jrengdahl/MSCP/QBusH723Z-JLCPCB-0.1/44007569240064-Produce_DanZhi.SMT_Snapshot.Top.5651051A_Y5.SMT02405081732156.png

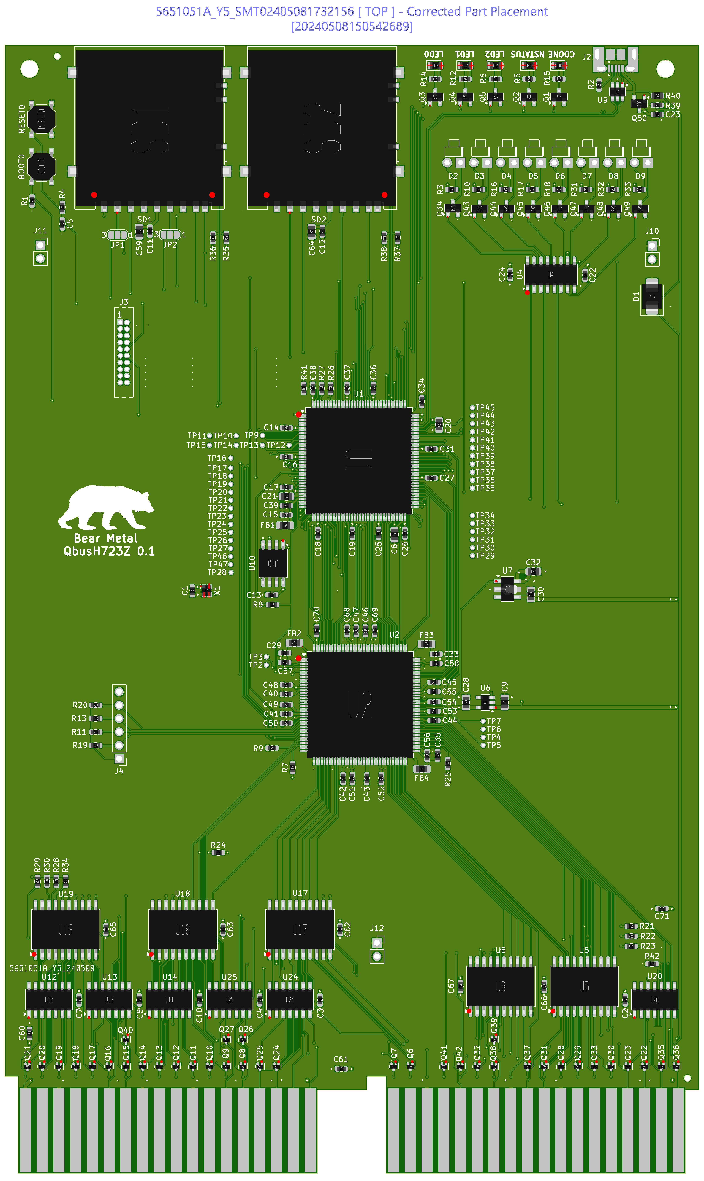
QBusH723Z-JLCPCB-0.1/44007569240064-Produce_DanZhi.SMT_Snapshot.Top.5651051A_Y5.SMT02405081732156.png
