jrengdahl/MSCP/QBusH723Z-JLCPCB-0.1/QBusH723Z.kicad_sch

## KiCad design QBusH723Z-JLCPCB-0.1/QBusH723Z.kicad_sch (2024-05-27)

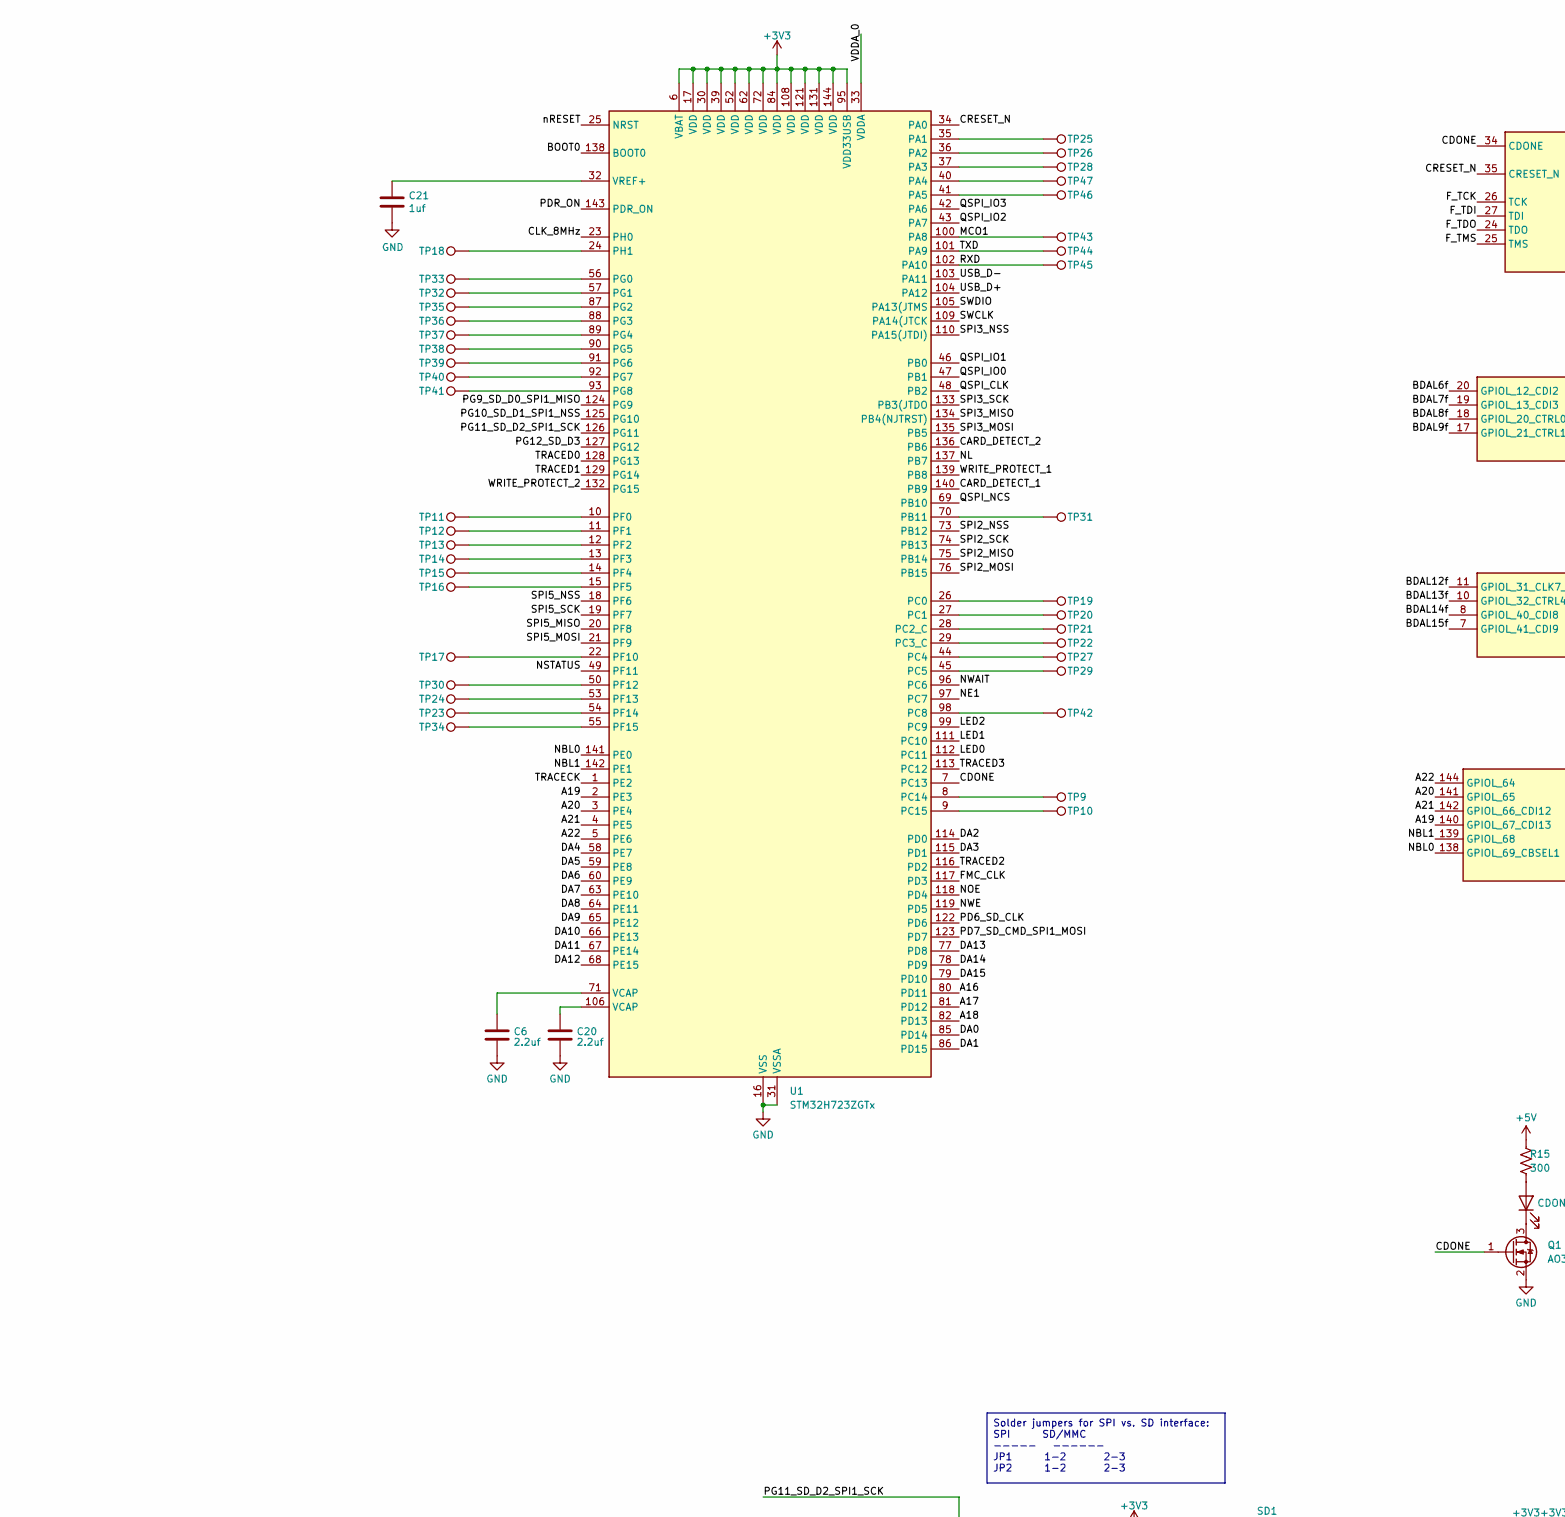
[picture p2: schematic QBusH723Z.kicad_sch, part in row 1, column 1]

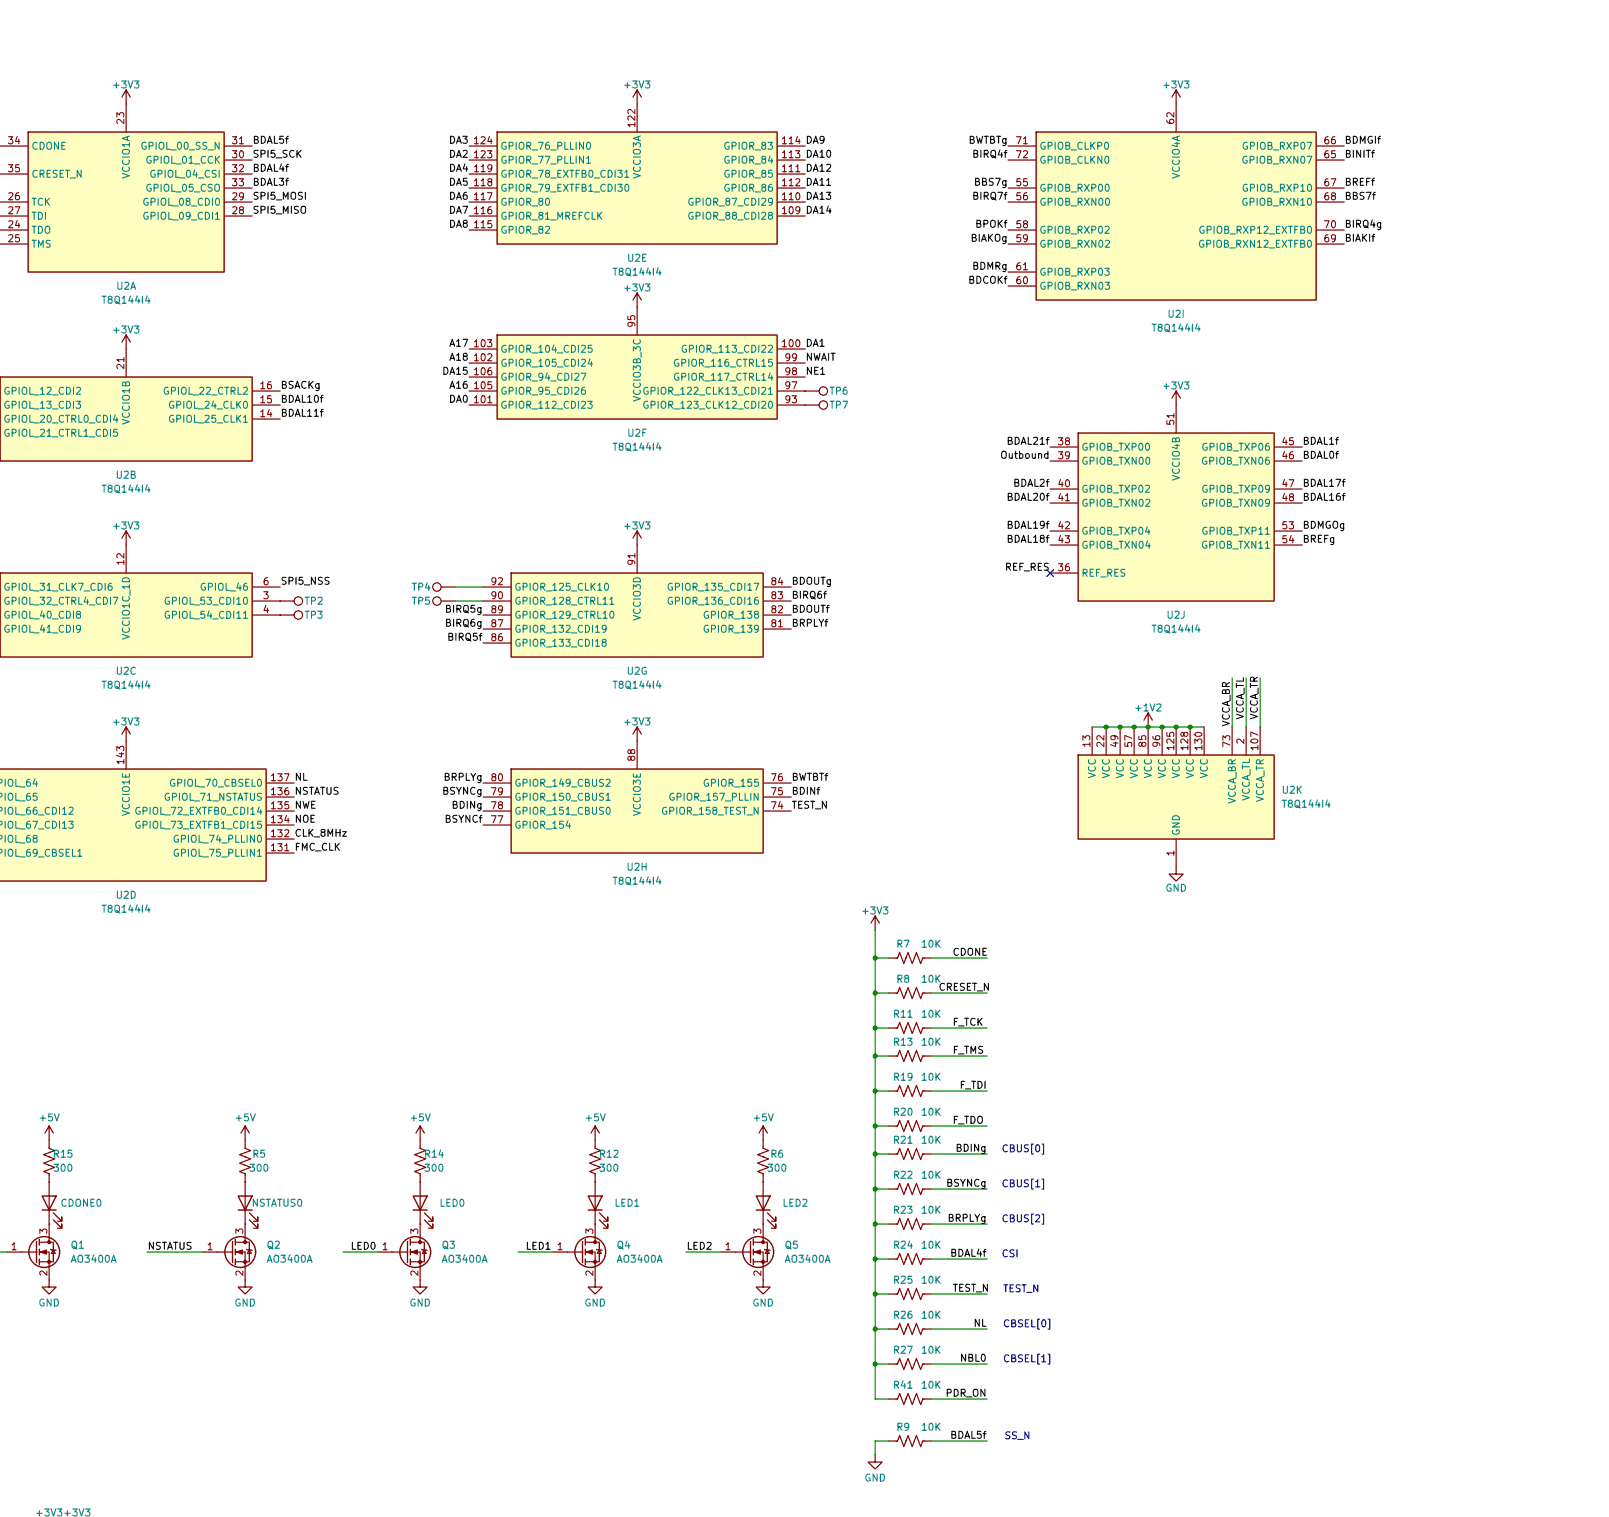
[picture p3: schematic QBusH723Z.kicad_sch, part in row 1, column 2]

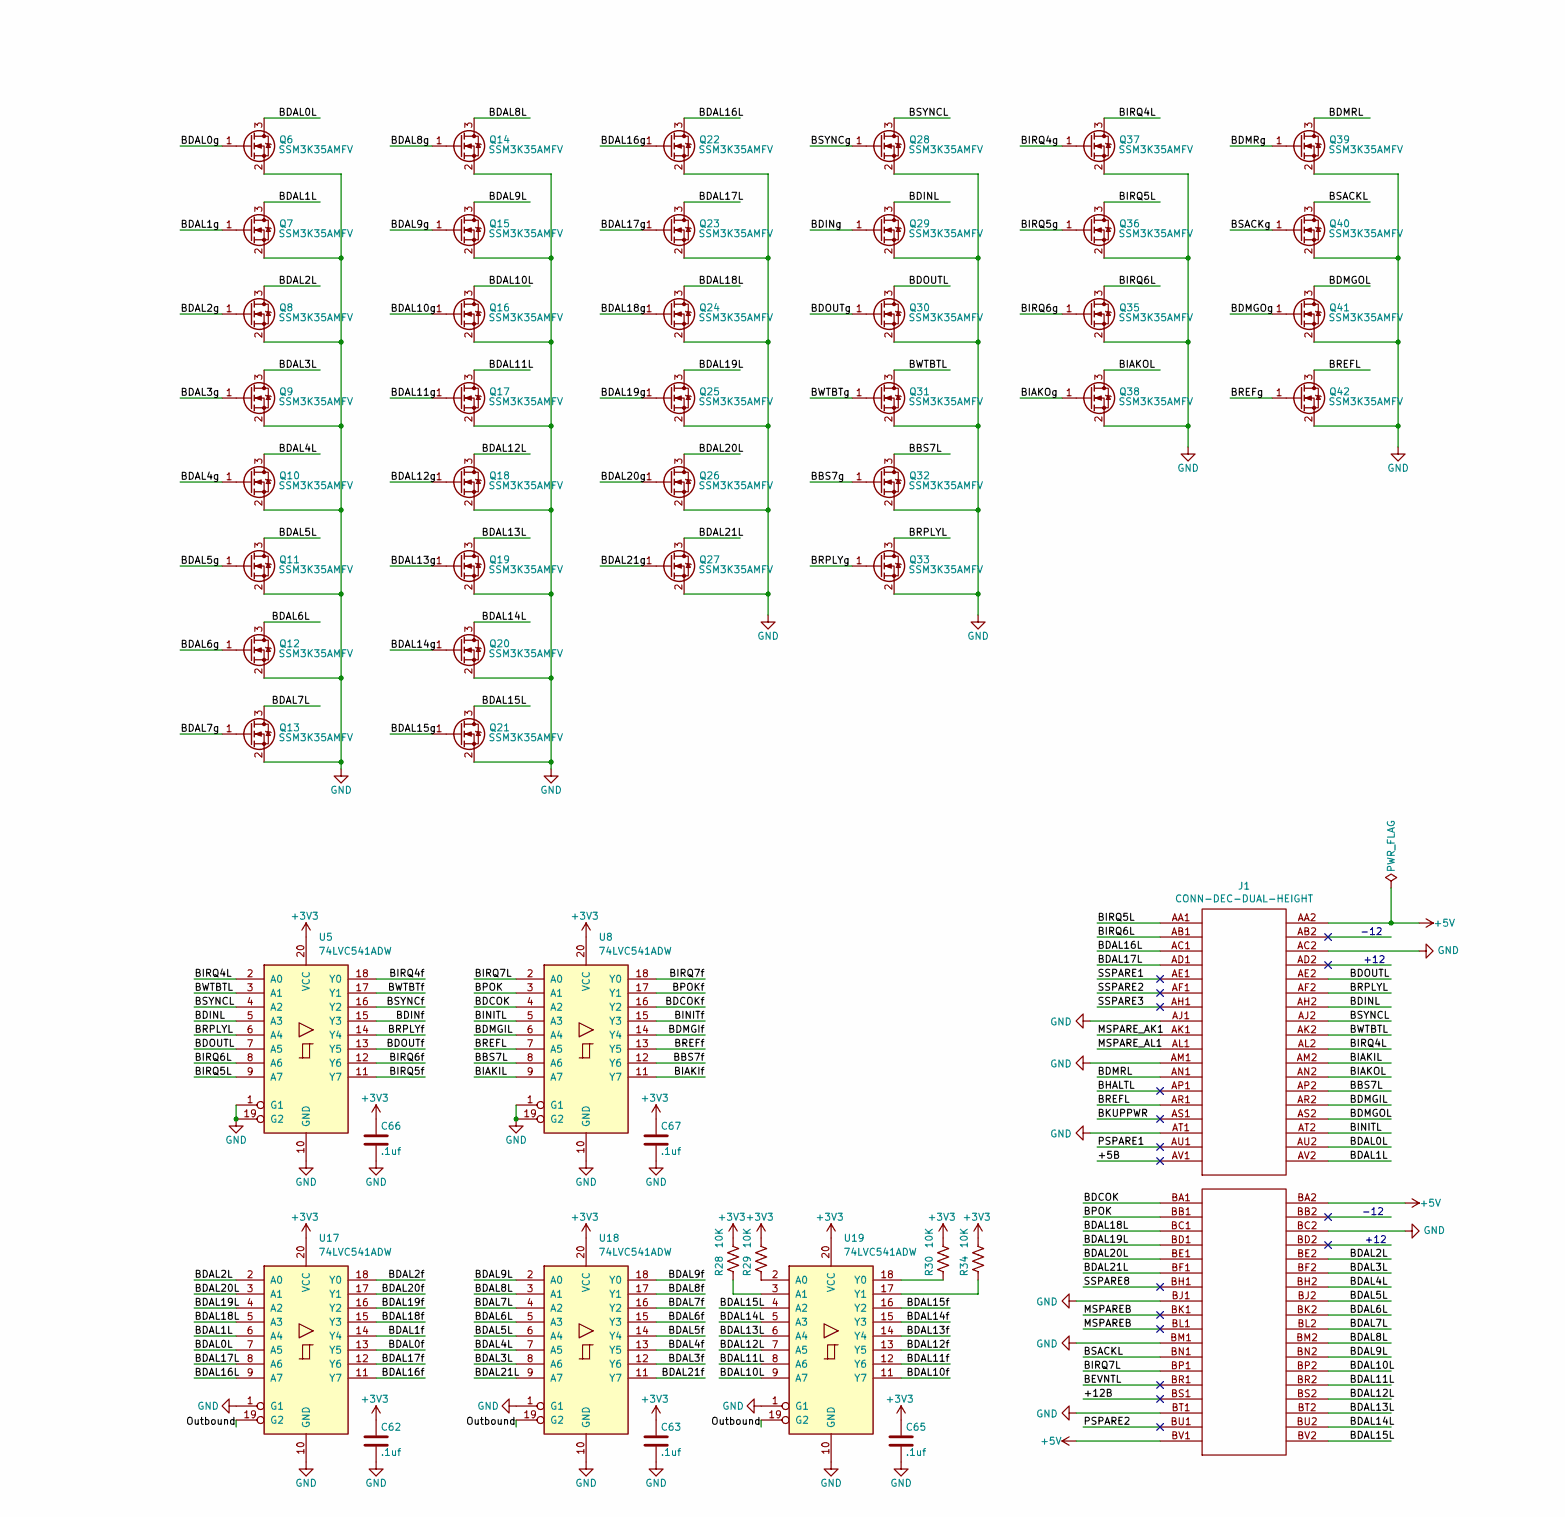
[picture p4: schematic QBusH723Z.kicad_sch, part in row 1, column 3]

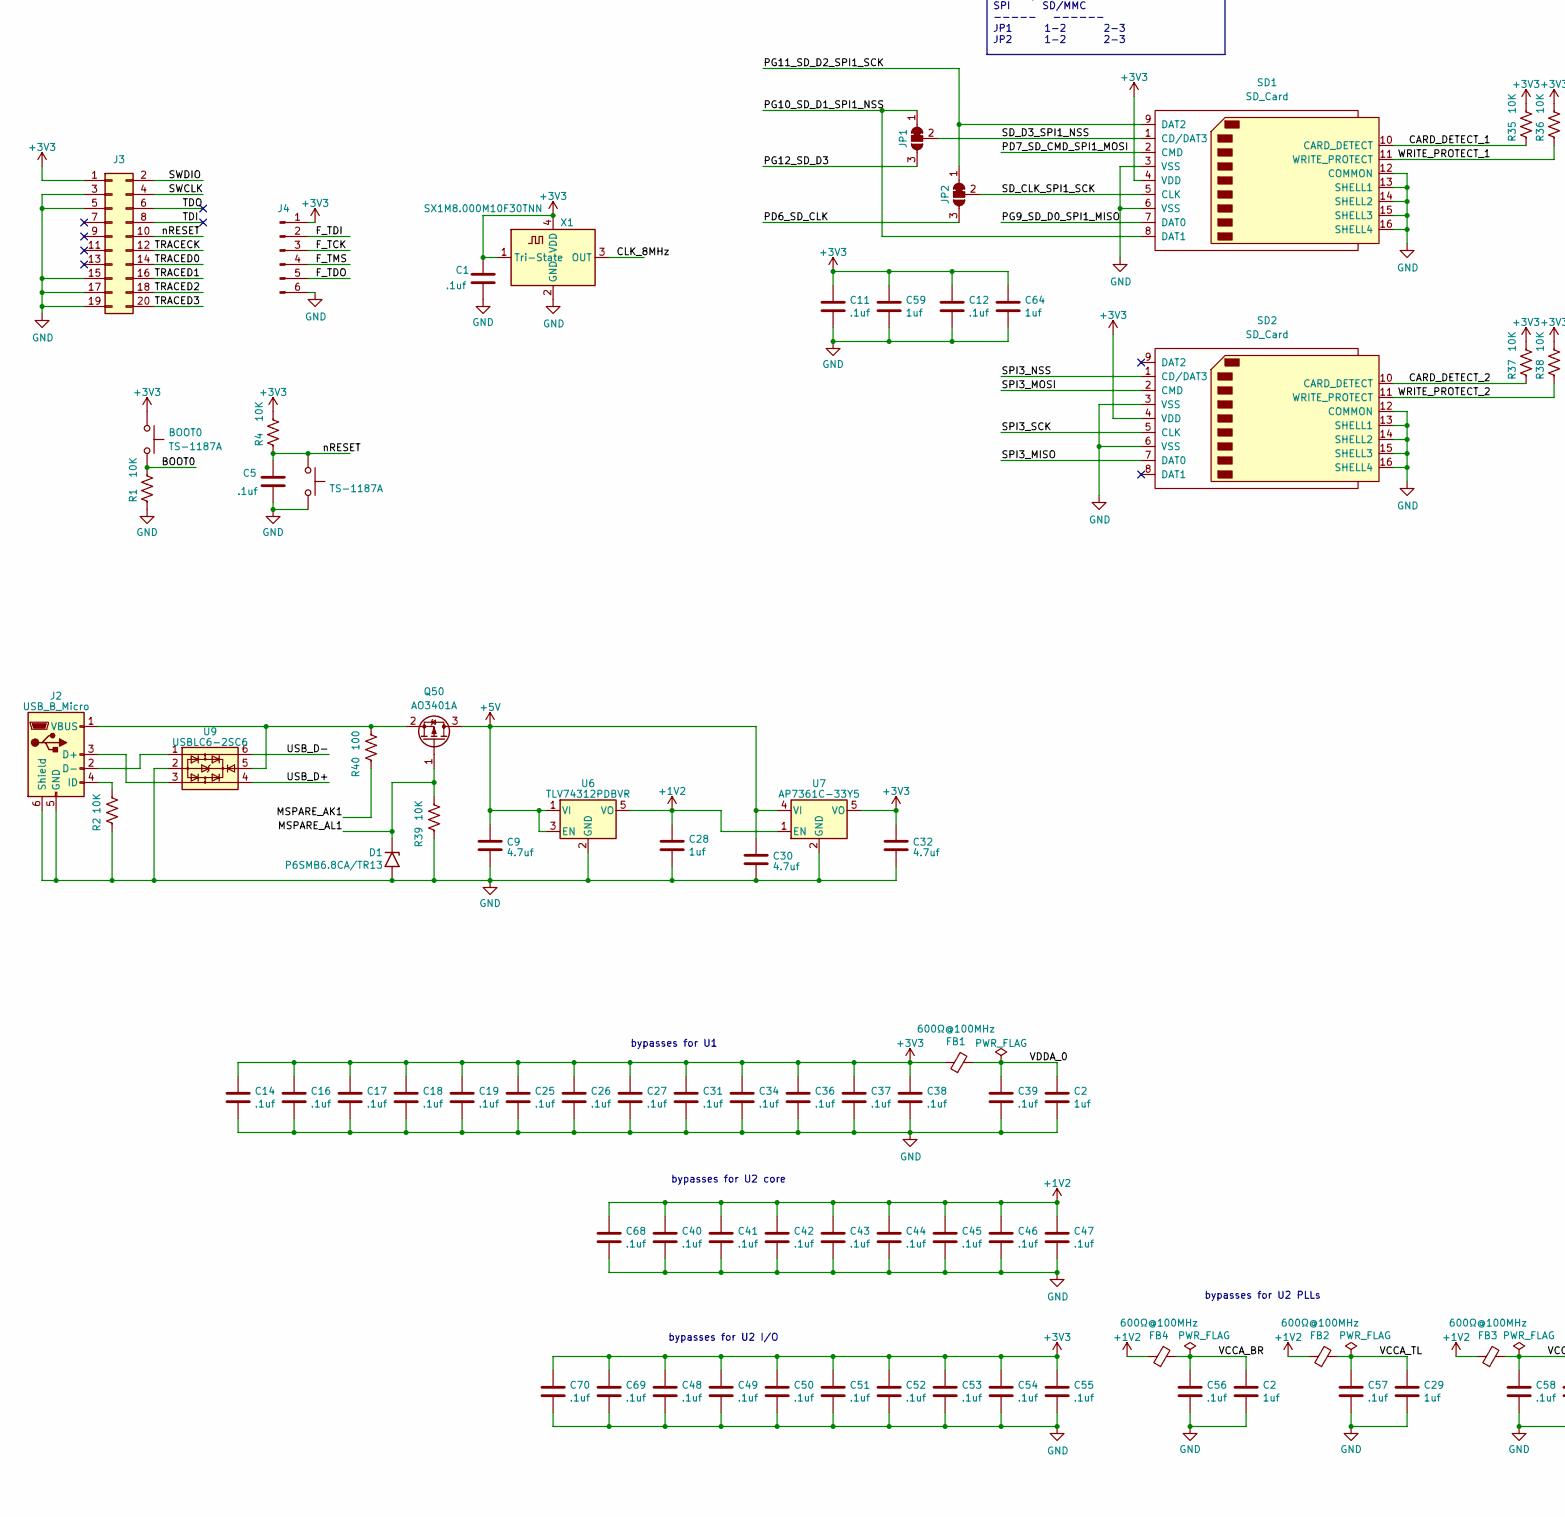
[picture p5: schematic QBusH723Z.kicad_sch, part in row 2, column 1]

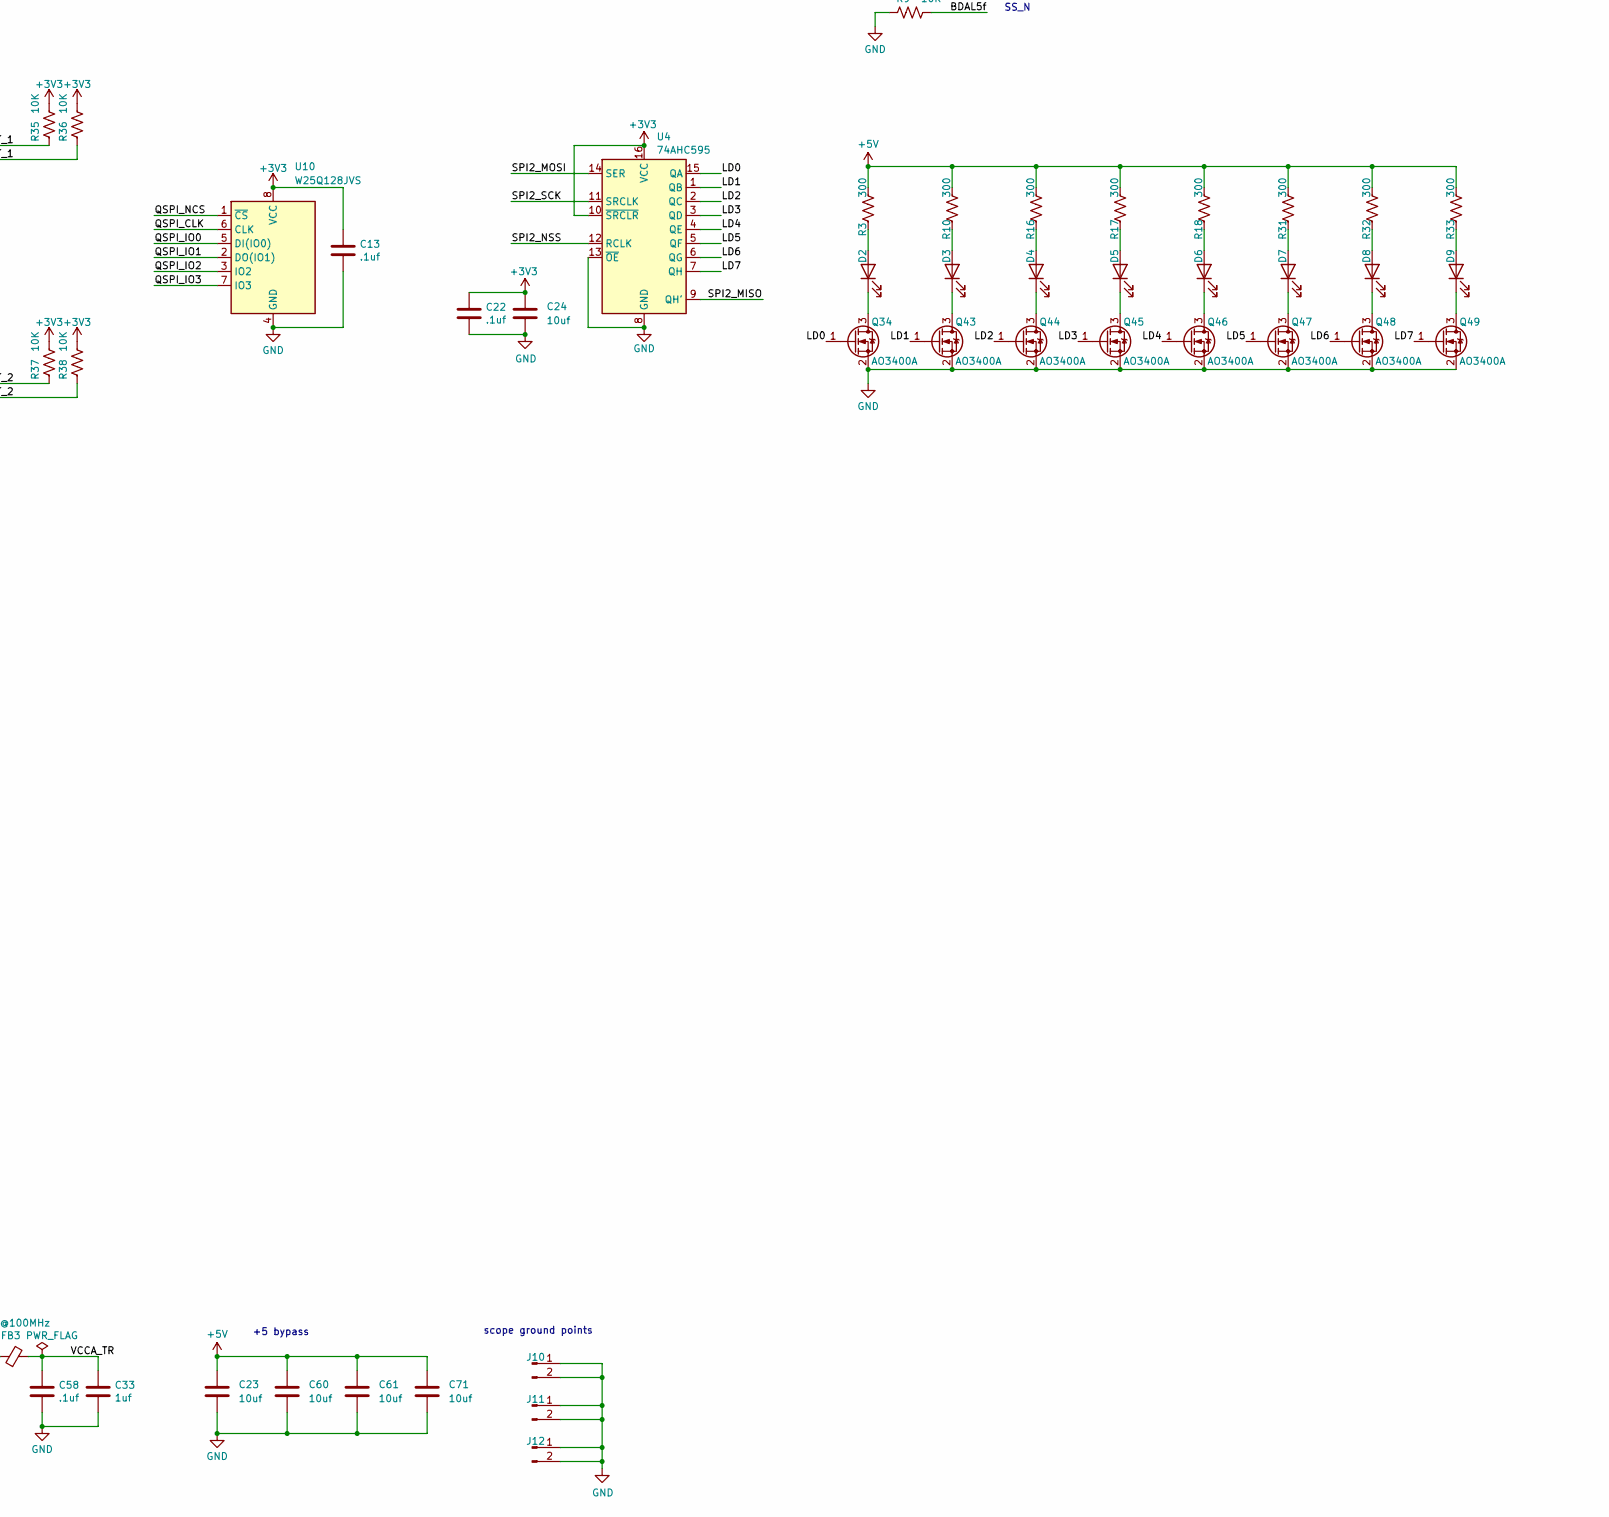
[picture p6: schematic QBusH723Z.kicad_sch, part in row 2, column 2]

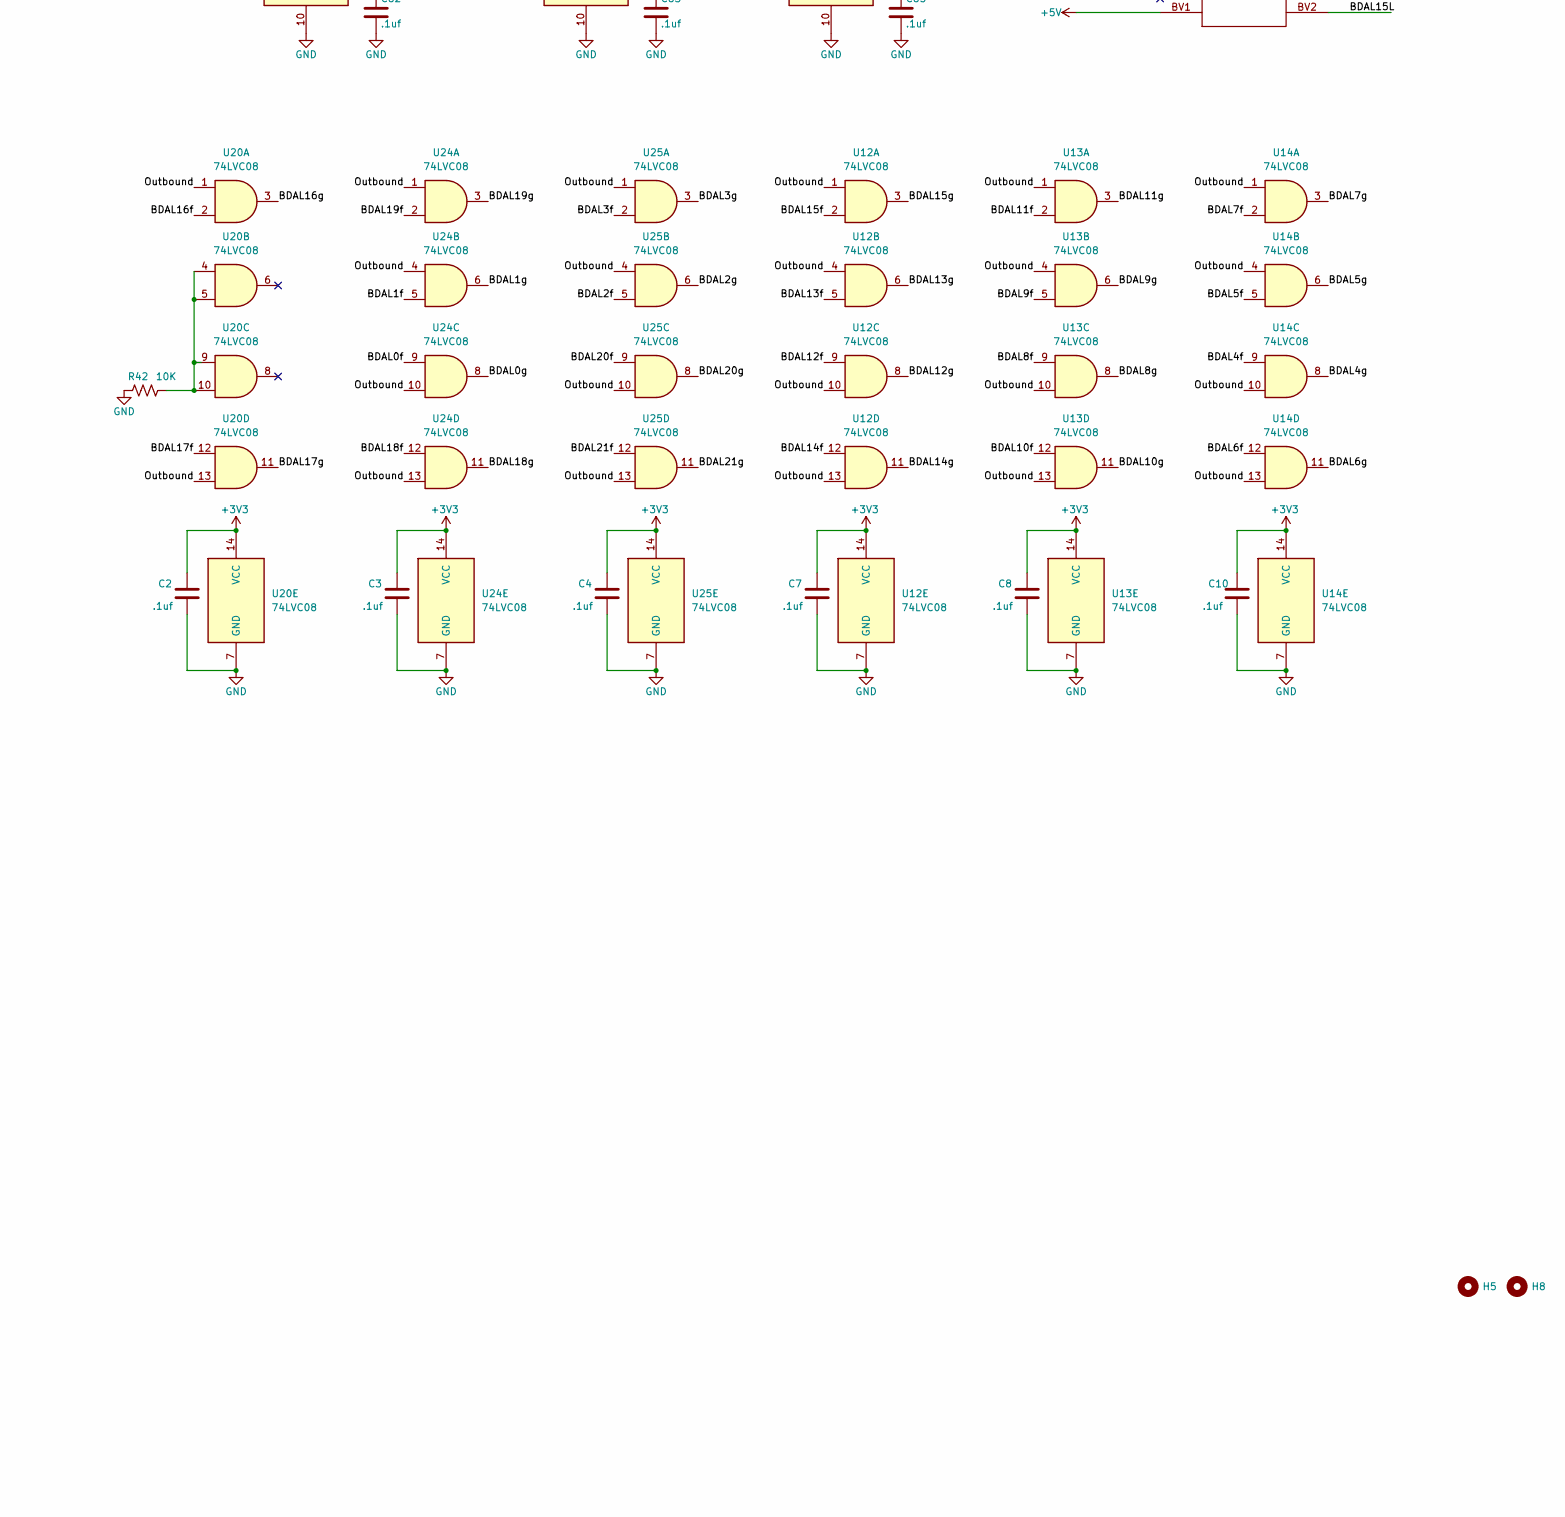
[picture p7: schematic QBusH723Z.kicad_sch, part in row 2, column 3]

Parts:
BOOT0: TS-1187A; SW_Push_1P1T_XKB_TS-1187A; LCSC C318884
C1, C3, C4, C5, C7, C8, C10, C11, C12, C13, C14, C16, C17, C18, C19, C22, C25, C26, C27, C31, C34, C36, C37, C38, C39, C40, C41, C42, C43, C44, C45, C46, C47, C48, C49, C50, C51, C52, C53, C54, C55, C56, C57, C58, C62, C63, C65, C66, C67, C68, C69, C70: .1uf; C_0603_1608Metric; LCSC C14663
C2, C29, C33: 1uf; C_0603_1608Metric; LCSC C15849
C6, C20: 2.2uf; C_0805_2012Metric; LCSC C377773
C9, C30, C32: 4.7uf; C_0805_2012Metric; LCSC C1779
C21, C28, C59, C64: 1uf; C_0805_2012Metric; LCSC C28323
C23, C24, C60, C61, C71: 10uf; C_0603_1608Metric; LCSC C19702
CDONE0: LED; LED_0805_2012Metric; LCSC C84256
D1: P6SMB6.8CA/TR13; D_SMB; LCSC C78395
D2, D3, D4, D5, D6, D7, D8, D9: LED; LED_D3.0mm_right_angle_holder
FB1, FB2, FB3, FB4: 600Ω@100MHz; C_0805_2012Metric_Pad1.18x1.45mm_HandSolder; LCSC C1017
H5, H8: MountingHole; MountingHole_3.2mm_M3
J1: CONN-DEC-DUAL-HEIGHT; DEC_Edge_Fingers_double_height
J2: USB_B_Micro; USB_Micro-B_Molex-105017-0002; LCSC C505322
J3: Conn_02x10_Odd_Even; Conn_02x10_Odd_Even_wide_connector
J4: Conn_01x06_Pin; PinHeader_1x06_P2.54mm_Vertical
J10, J11, J12: Conn_01x02_Pin; PinSocket_1x02_P2.54mm_Vertical
JP1, JP2: SolderJumper_3_Bridged12; SolderJumper-3_P1.3mm_Bridged12_RoundedPad1.0x1.5mm_NumberL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
LED0, LED1, LED2: LED; LED_0805_2012Metric; LCSC C84256
NSTATUS0: LED; LED_0805_2012Metric; LCSC C84256
Q1, Q2, Q3, Q4, Q5, Q34, Q43, Q44, Q45, Q46, Q47, Q48, Q49: AO3400A; SOT-23; LCSC C20917
Q6, Q7, Q8, Q9, Q10, Q11, Q12, Q13, Q14, Q15, Q16, Q17, Q18, Q19, Q20, Q21, Q22, Q23, Q24, Q25, Q26, Q27, Q28, Q29, Q30, Q31, Q32, Q33, Q35, Q36, Q37, Q38, Q39, Q40, Q41, Q42: SSM3K35AMFV; SOT-723; LCSC C150155
Q50: AO3401A; SOT-23; LCSC C15127
R1, R2, R4, R7, R8, R9, R11, R13, R19, R20, R21, R22, R23, R24, R25, R26, R27, R28, R29, R30, R34, R35, R36, R37, R38, R39, R41, R42: 10K; R_0603_1608Metric; LCSC C25804
R3, R5, R6, R10, R12, R14, R15, R16, R17, R18, R31, R32, R33: 300; R_0603_1608Metric; LCSC C23025
R40: 100; R_0603_1608Metric; LCSC C17408
RESET0: TS-1187A; SW_Push_1P1T_XKB_TS-1187A; LCSC C318884
SD1, SD2: SD_Card; SD_Hirose_DM1AA_SF_PEJ82; LCSC C506790
TP2, TP3, TP4, TP5, TP6, TP7, TP9, TP10, TP11, TP12, TP13, TP14, TP15, TP16, TP17, TP18, TP19, TP20, TP21, TP22, TP23, TP24, TP25, TP26, TP27, TP28, TP29, TP30, TP31, TP32, TP33, TP34, TP35, TP36, TP37, TP38, TP39, TP40, TP41, TP42, TP43, TP44, TP45, TP46, TP47: TestPoint; TestPoint_THTPad_D1.0mm_Drill0.5mm_min
U1: STM32H723ZGTx; LQFP-144_20x20mm_P0.5mm; LCSC C730146
U2: T8Q144I4; LQFP-144_20x20mm_P0.5mm; LCSC C7356605
U4: 74AHC595; SOIC-16_3.9x9.9mm_P1.27mm; LCSC C5947
U5, U8, U17, U18, U19: 74LVC541ADW; SOIC-20W_7.5x12.8mm_P1.27mm; LCSC C2652110
U6: TLV74312PDBVR; SOT-23-5; LCSC C485149
U7: AP7361C-33Y5; SOT-89-5; LCSC C460397
U9: USBLC6-2SC6; SOT-23-6; LCSC C2827654
U10: W25Q128JVS; SOIC-8_5.23x5.23mm_P1.27mm; LCSC C97521
U12, U13, U14, U20, U24, U25: 74LVC08; SOIC-14_3.9x8.7mm_P1.27mm; LCSC C6052
X1: SX1M8.000M10F30TNN; Crystal_SMD_2016-4Pin_2.0x1.6mm; LCSC C2901607

Connections:
+1V2: C28.1, C40.1, C41.1, C42.1, C43.1, C44.1, C45.1, C46.1, C47.1, C68.1, FB2.1, FB3.1, FB4.1, U2.13 (VCC), U2.22 (VCC), U2.49 (VCC), U2.57 (VCC), U2.85 (VCC), U2.96 (VCC), U2.125 (VCC), U2.128 (VCC), U2.130 (VCC), U6.5 (VO), U7.1 (EN)
+3V3: BOOT0.1, C1.1, C2.1, C3.1, C4.1, C7.1, C8.1, C10.1, C11.1, C12.1, C13.1, C14.1, C16.1, C17.1, C18.1, C19.1, C22.1, C24.1, C25.1, C26.1, C27.1, C31.1, C32.1, C34.1, C36.1, C37.1, C38.1, C48.1, C49.1, C50.1, C51.1, C52.1, C53.1, C54.1, C55.1, C59.1, C62.1, C63.1, C64.1, C65.1, C66.1, C67.1, C69.1, C70.1, FB1.1, J3.1, J4.1, R4.2, R7.1, R8.1, R11.1, R13.1, R19.1, R20.1, R21.1, R22.1, R23.1, R24.1, R25.1, R26.1, R27.1, R28.2, R29.2, R30.2, R34.2, R35.2, R36.2, R37.2, R38.2, R41.1, SD1.4 (VDD), SD2.4 (VDD), U1.6 (VBAT), U1.17 (VDD), U1.30 (VDD), U1.39 (VDD), U1.52 (VDD), U1.62 (VDD), U1.72 (VDD), U1.84 (VDD), U1.95 (VDD33USB), U1.108 (VDD), U1.121 (VDD), U1.131 (VDD), U1.144 (VDD), U2.12 (VCCIO1C_1D), U2.21 (VCCIO1B), U2.23 (VCCIO1A), U2.51 (VCCIO4B), U2.52 (VCCIO4B), U2.62 (VCCIO4A), U2.63 (VCCIO4A), U2.88 (VCCIO3E), U2.91 (VCCIO3D), U2.95 (VCCIO3B_3C), U2.122 (VCCIO3A), U2.143 (VCCIO1E), U4.10 (~SRCLR), U4.16 (VCC), U5.20 (VCC), U7.5 (VO), U8.20 (VCC), U10.8 (VCC), U12.14 (VCC), U13.14 (VCC), U14.14 (VCC), U17.20 (VCC), U18.20 (VCC), U19.20 (VCC), U20.14 (VCC), U24.14 (VCC), U25.14 (VCC), X1.1 (Tri-State), X1.4 (VDD)
+5B: J1.AV1
+5V: C9.1, C23.1, C30.1, C60.1, C61.1, C71.1, J1.AA2, J1.BA2, J1.BV1, Q50.3 (D), R3.2, R5.1, R6.1, R10.2, R12.1, R14.1, R15.1, R16.2, R17.2, R18.2, R31.2, R32.2, R33.2, U6.1 (VI), U6.3 (EN), U7.4 (VI)
+12B: J1.BS1
A16: U1.80 (PD11), U2.105 (GPIOR_95_CDI26)
A17: U1.81 (PD12), U2.103 (GPIOR_104_CDI25)
A18: U1.82 (PD13), U2.102 (GPIOR_105_CDI24)
A19: U1.2 (PE3), U2.140 (GPIOL_67_CDI13)
A20: U1.3 (PE4), U2.141 (GPIOL_65)
A21: U1.4 (PE5), U2.142 (GPIOL_66_CDI12)
A22: U1.5 (PE6), U2.144 (GPIOL_64)
BBS7L: J1.AP2, Q32.3 (D), U8.8 (A6)
BBS7f: U2.68 (GPIOB_RXN10), U8.12 (Y6)
BBS7g: Q32.1 (G), U2.55 (GPIOB_RXP00)
BDAL0L: J1.AU2, Q6.3 (D), U17.7 (A5)
BDAL0f: U2.46 (GPIOB_TXN06), U17.13 (Y5), U24.9
BDAL0g: Q6.1 (G), U24.8
BDAL1L: J1.AV2, Q7.3 (D), U17.6 (A4)
BDAL1f: U2.45 (GPIOB_TXP06), U17.14 (Y4), U24.5
BDAL1g: Q7.1 (G), U24.6
BDAL2L: J1.BE2, Q8.3 (D), U17.2 (A0)
BDAL2f: U2.40 (GPIOB_TXP02), U17.18 (Y0), U25.5
BDAL2g: Q8.1 (G), U25.6
BDAL3L: J1.BF2, Q9.3 (D), U18.8 (A6)
BDAL3f: U2.33 (GPIOL_05_CSO), U18.12 (Y6), U25.2
BDAL3g: Q9.1 (G), U25.3
BDAL4L: J1.BH2, Q10.3 (D), U18.7 (A5)
BDAL4f: R24.2, U2.32 (GPIOL_04_CSI), U14.9, U18.13 (Y5)
BDAL4g: Q10.1 (G), U14.8
BDAL5L: J1.BJ2, Q11.3 (D), U18.6 (A4)
BDAL5f: R9.2, U2.31 (GPIOL_00_SS_N), U14.5, U18.14 (Y4)
BDAL5g: Q11.1 (G), U14.6
BDAL6L: J1.BK2, Q12.3 (D), U18.5 (A3)
BDAL6f: U2.20 (GPIOL_12_CDI2), U14.12, U18.15 (Y3)
BDAL6g: Q12.1 (G), U14.11
BDAL7L: J1.BL2, Q13.3 (D), U18.4 (A2)
BDAL7f: U2.19 (GPIOL_13_CDI3), U14.2, U18.16 (Y2)
BDAL7g: Q13.1 (G), U14.3
BDAL8L: J1.BM2, Q14.3 (D), U18.3 (A1)
BDAL8f: U2.18 (GPIOL_20_CTRL0_CDI4), U13.9, U18.17 (Y1)
BDAL8g: Q14.1 (G), U13.8
BDAL9L: J1.BN2, Q15.3 (D), U18.2 (A0)
BDAL9f: U2.17 (GPIOL_21_CTRL1_CDI5), U13.5, U18.18 (Y0)
BDAL9g: Q15.1 (G), U13.6
BDAL10L: J1.BP2, Q16.3 (D), U19.9 (A7)
BDAL10f: U2.15 (GPIOL_24_CLK0), U13.12, U19.11 (Y7)
BDAL10g: Q16.1 (G), U13.11
BDAL11L: J1.BR2, Q17.3 (D), U19.8 (A6)
BDAL11f: U2.14 (GPIOL_25_CLK1), U13.2, U19.12 (Y6)
BDAL11g: Q17.1 (G), U13.3
BDAL12L: J1.BS2, Q18.3 (D), U19.7 (A5)
BDAL12f: U2.11 (GPIOL_31_CLK7_CDI6), U12.9, U19.13 (Y5)
BDAL12g: Q18.1 (G), U12.8
BDAL13L: J1.BT2, Q19.3 (D), U19.6 (A4)
BDAL13f: U2.10 (GPIOL_32_CTRL4_CDI7), U12.5, U19.14 (Y4)
BDAL13g: Q19.1 (G), U12.6
BDAL14L: J1.BU2, Q20.3 (D), U19.5 (A3)
BDAL14f: U2.8 (GPIOL_40_CDI8), U12.12, U19.15 (Y3)
BDAL14g: Q20.1 (G), U12.11
BDAL15L: J1.BV2, Q21.3 (D), U19.4 (A2)
BDAL15f: U2.7 (GPIOL_41_CDI9), U12.2, U19.16 (Y2)
BDAL15g: Q21.1 (G), U12.3
BDAL16L: J1.AC1, Q22.3 (D), U17.9 (A7)
BDAL16f: U2.48 (GPIOB_TXN09), U17.11 (Y7), U20.2
BDAL16g: Q22.1 (G), U20.3
BDAL17L: J1.AD1, Q23.3 (D), U17.8 (A6)
BDAL17f: U2.47 (GPIOB_TXP09), U17.12 (Y6), U20.12
BDAL17g: Q23.1 (G), U20.11
BDAL18L: J1.BC1, Q24.3 (D), U17.5 (A3)
BDAL18f: U2.43 (GPIOB_TXN04), U17.15 (Y3), U24.12
BDAL18g: Q24.1 (G), U24.11
BDAL19L: J1.BD1, Q25.3 (D), U17.4 (A2)
BDAL19f: U2.42 (GPIOB_TXP04), U17.16 (Y2), U24.2
BDAL19g: Q25.1 (G), U24.3
BDAL20L: J1.BE1, Q26.3 (D), U17.3 (A1)
BDAL20f: U2.41 (GPIOB_TXN02), U17.17 (Y1), U25.9
BDAL20g: Q26.1 (G), U25.8
BDAL21L: J1.BF1, Q27.3 (D), U18.9 (A7)
BDAL21f: U2.38 (GPIOB_TXP00), U18.11 (Y7), U25.12
BDAL21g: Q27.1 (G), U25.11
BDCOK: J1.BA1, U8.4 (A2)
BDCOKf: U2.60 (GPIOB_RXN03), U8.16 (Y2)
BDINL: J1.AH2, Q29.3 (D), U5.5 (A3)
BDINf: U2.75 (GPIOR_157_PLLIN), U5.15 (Y3)
BDINg: Q29.1 (G), R21.2, U2.78 (GPIOR_151_CBUS0)
BDMGIL: J1.AR2, U8.6 (A4)
BDMGIf: U2.66 (GPIOB_RXP07), U8.14 (Y4)
BDMGOL: J1.AS2, Q41.3 (D)
BDMGOg: Q41.1 (G), U2.53 (GPIOB_TXP11)
BDMRL: J1.AN1, Q39.3 (D)
BDMRg: Q39.1 (G), U2.61 (GPIOB_RXP03)
BDOUTL: J1.AE2, Q30.3 (D), U5.7 (A5)
BDOUTf: U2.82 (GPIOR_138), U5.13 (Y5)
BDOUTg: Q30.1 (G), U2.84 (GPIOR_135_CDI17)
BEVNTL: J1.BR1
BHALTL: J1.AP1
BIAKIL: J1.AM2, U8.9 (A7)
BIAKIf: U2.69 (GPIOB_RXN12_EXTFB0), U8.11 (Y7)
BIAKOL: J1.AN2, Q38.3 (D)
BIAKOg: Q38.1 (G), U2.59 (GPIOB_RXN02)
BINITL: J1.AT2, U8.5 (A3)
BINITf: U2.65 (GPIOB_RXN07), U8.15 (Y3)
BIRQ4L: J1.AL2, Q37.3 (D), U5.2 (A0)
BIRQ4f: U2.72 (GPIOB_CLKN0), U5.18 (Y0)
BIRQ4g: Q37.1 (G), U2.70 (GPIOB_RXP12_EXTFB0)
BIRQ5L: J1.AA1, Q36.3 (D), U5.9 (A7)
BIRQ5f: U2.86 (GPIOR_133_CDI18), U5.11 (Y7)
BIRQ5g: Q36.1 (G), U2.89 (GPIOR_129_CTRL10)
BIRQ6L: J1.AB1, Q35.3 (D), U5.8 (A6)
BIRQ6f: U2.83 (GPIOR_136_CDI16), U5.12 (Y6)
BIRQ6g: Q35.1 (G), U2.87 (GPIOR_132_CDI19)
BIRQ7L: J1.BP1, U8.2 (A0)
BIRQ7f: U2.56 (GPIOB_RXN00), U8.18 (Y0)
BKUPPWR: J1.AS1
BOOT0: BOOT0.2, R1.2, U1.138 (BOOT0)
BPOK: J1.BB1, U8.3 (A1)
BPOKf: U2.58 (GPIOB_RXP02), U8.17 (Y1)
BREFL: J1.AR1, Q42.3 (D), U8.7 (A5)
BREFf: U2.67 (GPIOB_RXP10), U8.13 (Y5)
BREFg: Q42.1 (G), U2.54 (GPIOB_TXN11)
BRPLYL: J1.AF2, Q33.3 (D), U5.6 (A4)
BRPLYf: U2.81 (GPIOR_139), U5.14 (Y4)
BRPLYg: Q33.1 (G), R23.2, U2.80 (GPIOR_149_CBUS2)
BSACKL: J1.BN1, Q40.3 (D)
BSACKg: Q40.1 (G), U2.16 (GPIOL_22_CTRL2)
BSYNCL: J1.AJ2, Q28.3 (D), U5.4 (A2)
BSYNCf: U2.77 (GPIOR_154), U5.16 (Y2)
BSYNCg: Q28.1 (G), R22.2, U2.79 (GPIOR_150_CBUS1)
BWTBTL: J1.AK2, Q31.3 (D), U5.3 (A1)
BWTBTf: U2.76 (GPIOR_155), U5.17 (Y1)
BWTBTg: Q31.1 (G), U2.71 (GPIOB_CLKP0)
CARD_DETECT_1: R35.1, SD1.10 (CARD_DETECT), U1.140 (PB9)
CARD_DETECT_2: R37.1, SD2.10 (CARD_DETECT), U1.136 (PB6)
CDONE: Q1.1 (G), R7.2, U1.7 (PC13), U2.34 (CDONE)
CLK_8MHz: U1.23 (PH0), U2.132 (GPIOL_74_PLLIN0), X1.3 (OUT)
CRESET_N: R8.2, U1.34 (PA0), U2.35 (CRESET_N)
DA0: U1.85 (PD14), U2.101 (GPIOR_112_CDI23)
DA1: U1.86 (PD15), U2.100 (GPIOR_113_CDI22)
DA2: U1.114 (PD0), U2.123 (GPIOR_77_PLLIN1)
DA3: U1.115 (PD1), U2.124 (GPIOR_76_PLLIN0)
DA4: U1.58 (PE7), U2.119 (GPIOR_78_EXTFB0_CDI31)
DA5: U1.59 (PE8), U2.118 (GPIOR_79_EXTFB1_CDI30)
DA6: U1.60 (PE9), U2.117 (GPIOR_80)
DA7: U1.63 (PE10), U2.116 (GPIOR_81_MREFCLK)
DA8: U1.64 (PE11), U2.115 (GPIOR_82)
DA9: U1.65 (PE12), U2.114 (GPIOR_83)
DA10: U1.66 (PE13), U2.113 (GPIOR_84)
DA11: U1.67 (PE14), U2.112 (GPIOR_86)
DA12: U1.68 (PE15), U2.111 (GPIOR_85)
DA13: U1.77 (PD8), U2.110 (GPIOR_87_CDI29)
DA14: U1.78 (PD9), U2.109 (GPIOR_88_CDI28)
DA15: U1.79 (PD10), U2.106 (GPIOR_94_CDI27)
FMC_CLK: U1.117 (PD3), U2.131 (GPIOL_75_PLLIN1)
F_TCK: J4.3, R11.2, U2.26 (TCK)
F_TDI: J4.2, R19.2, U2.27 (TDI)
F_TDO: J4.5, R20.2, U2.24 (TDO)
F_TMS: J4.4, R13.2, U2.25 (TMS)
GND: C1.2, C2.2, C3.2, C4.2, C5.2, C6.2, C7.2, C8.2, C9.2, C10.2, C11.2, C12.2, C13.2, C14.2, C16.2, C17.2, C18.2, C19.2, C20.2, C21.2, C22.2, C23.2, C24.2, C25.2, C26.2, C27.2, C28.2, C29.2, C30.2, C31.2, C32.2, C33.2, C34.2, C36.2, C37.2, C38.2, C39.2, C40.2, C41.2, C42.2, C43.2, C44.2, C45.2, C46.2, C47.2, C48.2, C49.2, C50.2, C51.2, C52.2, C53.2, C54.2, C55.2, C56.2, C57.2, C58.2, C59.2, C60.2, C61.2, C62.2, C63.2, C64.2, C65.2, C66.2, C67.2, C68.2, C69.2, C70.2, C71.2, D1.2 (A2), J1.AC2, J1.AJ1, J1.AM1, J1.AT1, J1.BC2, J1.BJ1, J1.BM1, J1.BT1, J2.5 (GND), J2.6 (Shield), J3.3, J3.5, J3.15, J3.17, J3.19, J4.6, J10.1, J10.2, J11.1, J11.2, J12.1, J12.2, Q1.2 (S), Q2.2 (S), Q3.2 (S), Q4.2 (S), Q5.2 (S), Q6.2 (S), Q7.2 (S), Q8.2 (S), Q9.2 (S), Q10.2 (S), Q11.2 (S), Q12.2 (S), Q13.2 (S), Q14.2 (S), Q15.2 (S), Q16.2 (S), Q17.2 (S), Q18.2 (S), Q19.2 (S), Q20.2 (S), Q21.2 (S), Q22.2 (S), Q23.2 (S), Q24.2 (S), Q25.2 (S), Q26.2 (S), Q27.2 (S), Q28.2 (S), Q29.2 (S), Q30.2 (S), Q31.2 (S), Q32.2 (S), Q33.2 (S), Q34.2 (S), Q35.2 (S), Q36.2 (S), Q37.2 (S), Q38.2 (S), Q39.2 (S), Q40.2 (S), Q41.2 (S), Q42.2 (S), Q43.2 (S), Q44.2 (S), Q45.2 (S), Q46.2 (S), Q47.2 (S), Q48.2 (S), Q49.2 (S), R1.1, R2.1, R9.1, R39.1, R42.1, RESET0.2, SD1.3 (VSS), SD1.6 (VSS), SD1.12 (COMMON), SD1.13 (SHELL1), SD1.14 (SHELL2), SD1.15 (SHELL3), SD1.16 (SHELL4), SD2.3 (VSS), SD2.6 (VSS), SD2.12 (COMMON), SD2.13 (SHELL1), SD2.14 (SHELL2), SD2.15 (SHELL3), SD2.16 (SHELL4), U1.16 (VSS), U1.31 (VSSA), U1.38 (VSS), U1.51 (VSS), U1.61 (VSS), U1.83 (VSS), U1.94 (VSS), U1.107 (VSS), U1.120 (VSS), U1.130 (VSS), U2.1 (GND), U2.5 (GND), U2.9 (GND), U2.37 (GND), U2.44 (GND), U2.50 (GND), U2.64 (GND), U2.94 (GND), U2.104 (GND), U2.108 (GND), U2.120 (GND), U2.121 (GND), U2.126 (GND), U2.127 (GND), U2.129 (GND), U2.133 (GND), U4.8 (GND), U4.13 (~OE), U5.1 (G1), U5.10 (GND), U5.19 (G2), U6.2 (GND), U7.2 (GND), U8.1 (G1), U8.10 (GND), U8.19 (G2), U9.2, U10.4 (GND), U12.7 (GND), U13.7 (GND), U14.7 (GND), U17.1 (G1), U17.10 (GND), U18.1 (G1), U18.10 (GND), U19.1 (G1), U19.10 (GND), U20.7 (GND), U24.7 (GND), U25.7 (GND), X1.2 (GND)
LD0: Q34.1 (G), U4.15 (QA)
LD1: Q43.1 (G), U4.1 (QB)
LD2: Q44.1 (G), U4.2 (QC)
LD3: Q45.1 (G), U4.3 (QD)
LD4: Q46.1 (G), U4.4 (QE)
LD5: Q47.1 (G), U4.5 (QF)
LD6: Q48.1 (G), U4.6 (QG)
LD7: Q49.1 (G), U4.7 (QH)
LED0: Q3.1 (G), U1.112 (PC11)
LED1: Q4.1 (G), U1.111 (PC10)
LED2: Q5.1 (G), U1.99 (PC9)
MCO1: TP43.1, U1.100 (PA8)
MSPAREB: J1.BL1
MSPAREB: J1.BK1
MSPARE_AK1: J1.AK1, R40.1
MSPARE_AL1: D1.1 (A1), J1.AL1, Q50.1 (G), R39.2
NBL0: R27.2, U1.141 (PE0), U2.138 (GPIOL_69_CBSEL1)
NBL1: U1.142 (PE1), U2.139 (GPIOL_68)
NE1: U1.97 (PC7), U2.98 (GPIOR_117_CTRL14)
NL: R26.2, U1.137 (PB7), U2.137 (GPIOL_70_CBSEL0)
NOE: U1.118 (PD4), U2.134 (GPIOL_73_EXTFB1_CDI15)
NSTATUS: Q2.1 (G), U1.49 (PF11), U2.136 (GPIOL_71_NSTATUS)
NWAIT: U1.96 (PC6), U2.99 (GPIOR_116_CTRL15)
NWE: U1.119 (PD5), U2.135 (GPIOL_72_EXTFB0_CDI14)
unnamed: C6.1, U1.71 (VCAP)
unnamed: C20.1, U1.106 (VCAP)
unnamed: C21.1, U1.32 (VREF+)
unnamed: CDONE0.1 (K), Q1.3 (D)
unnamed: CDONE0.2 (A), R15.2
unnamed: D2.1 (K), Q34.3 (D)
unnamed: D2.2 (A), R3.1
unnamed: D3.1 (K), Q43.3 (D)
unnamed: D3.2 (A), R10.1
unnamed: D4.1 (K), Q44.3 (D)
unnamed: D4.2 (A), R16.1
unnamed: D5.1 (K), Q45.3 (D)
unnamed: D5.2 (A), R17.1
unnamed: D6.1 (K), Q46.3 (D)
unnamed: D6.2 (A), R18.1
unnamed: D7.1 (K), Q47.3 (D)
unnamed: D7.2 (A), R31.1
unnamed: D8.1 (K), Q48.3 (D)
unnamed: D8.2 (A), R32.1
unnamed: D9.1 (K), Q49.3 (D)
unnamed: D9.2 (A), R33.1
unnamed: J2.1 (VBUS), Q50.2 (S), R40.2, U9.5
unnamed: J2.2 (D-), U9.1
unnamed: J2.3 (D+), U9.3
unnamed: J2.4 (ID), R2.2
unnamed: LED0.1 (K), Q3.3 (D)
unnamed: LED0.2 (A), R14.2
unnamed: LED1.1 (K), Q4.3 (D)
unnamed: LED1.2 (A), R12.2
unnamed: LED2.1 (K), Q5.3 (D)
unnamed: LED2.2 (A), R6.2
unnamed: NSTATUS0.1 (K), Q2.3 (D)
unnamed: NSTATUS0.2 (A), R5.2
unnamed: R28.1, U19.3 (A1)
unnamed: R29.1, U19.2 (A0)
unnamed: R30.1, U19.18 (Y0)
unnamed: R34.1, U19.17 (Y1)
unnamed: R42.2, U20.4, U20.5, U20.9, U20.10
unnamed: TP2.1, U2.3 (GPIOL_53_CDI10)
unnamed: TP3.1, U2.4 (GPIOL_54_CDI11)
unnamed: TP4.1, U2.92 (GPIOR_125_CLK10)
unnamed: TP5.1, U2.90 (GPIOR_128_CTRL11)
unnamed: TP6.1, U2.97 (GPIOR_122_CLK13_CDI21)
unnamed: TP7.1, U2.93 (GPIOR_123_CLK12_CDI20)
unnamed: TP9.1, U1.8 (PC14)
unnamed: TP10.1, U1.9 (PC15)
unnamed: TP11.1, U1.10 (PF0)
unnamed: TP12.1, U1.11 (PF1)
unnamed: TP13.1, U1.12 (PF2)
unnamed: TP14.1, U1.13 (PF3)
unnamed: TP15.1, U1.14 (PF4)
unnamed: TP16.1, U1.15 (PF5)
unnamed: TP17.1, U1.22 (PF10)
unnamed: TP18.1, U1.24 (PH1)
unnamed: TP19.1, U1.26 (PC0)
unnamed: TP20.1, U1.27 (PC1)
unnamed: TP21.1, U1.28 (PC2_C)
unnamed: TP22.1, U1.29 (PC3_C)
unnamed: TP23.1, U1.54 (PF14)
unnamed: TP24.1, U1.53 (PF13)
unnamed: TP25.1, U1.35 (PA1)
unnamed: TP26.1, U1.36 (PA2)
unnamed: TP27.1, U1.44 (PC4)
unnamed: TP28.1, U1.37 (PA3)
unnamed: TP29.1, U1.45 (PC5)
unnamed: TP30.1, U1.50 (PF12)
unnamed: TP31.1, U1.70 (PB11)
unnamed: TP32.1, U1.57 (PG1)
unnamed: TP33.1, U1.56 (PG0)
unnamed: TP34.1, U1.55 (PF15)
unnamed: TP35.1, U1.87 (PG2)
unnamed: TP36.1, U1.88 (PG3)
unnamed: TP37.1, U1.89 (PG4)
unnamed: TP38.1, U1.90 (PG5)
unnamed: TP39.1, U1.91 (PG6)
unnamed: TP40.1, U1.92 (PG7)
unnamed: TP41.1, U1.93 (PG8)
unnamed: TP42.1, U1.98 (PC8)
unnamed: TP46.1, U1.41 (PA5)
unnamed: TP47.1, U1.40 (PA4)
Outbound: U2.39 (GPIOB_TXN00), U12.1, U12.4, U12.10, U12.13, U13.1, U13.4, U13.10, U13.13, U14.1, U14.4, U14.10, U14.13, U17.19 (G2), U18.19 (G2), U19.19 (G2), U20.1, U20.13, U24.1, U24.4, U24.10, U24.13, U25.1, U25.4, U25.10, U25.13
PD6_SD_CLK: JP2.3 (B), U1.122 (PD6)
PD7_SD_CMD_SPI1_MOSI: SD1.2 (CMD), U1.123 (PD7)
PDR_ON: R41.2, U1.143 (PDR_ON)
PG9_SD_D0_SPI1_MISO: SD1.7 (DAT0), U1.124 (PG9)
PG10_SD_D1_SPI1_NSS: JP1.1 (A), SD1.8 (DAT1), U1.125 (PG10)
PG11_SD_D2_SPI1_SCK: JP2.1 (A), SD1.9 (DAT2), U1.126 (PG11)
PG12_SD_D3: JP1.3 (B), U1.127 (PG12)
PSPARE1: J1.AU1
PSPARE2: J1.BU1
QSPI_CLK: U1.48 (PB2), U10.6 (CLK)
QSPI_IO0: U1.47 (PB1), U10.5 (DI(IO0))
QSPI_IO1: U1.46 (PB0), U10.2 (DO(IO1))
QSPI_IO2: U1.43 (PA7), U10.3 (IO2)
QSPI_IO3: U1.42 (PA6), U10.7 (IO3)
QSPI_NCS: U1.69 (PB10), U10.1 (~CS)
REF_RES: U2.36 (REF_RES)
RXD: TP45.1, U1.102 (PA10)
SD_CLK_SPI1_SCK: JP2.2 (C), SD1.5 (CLK)
SD_D3_SPI1_NSS: JP1.2 (C), SD1.1 (CD/DAT3)
SPI2_MISO: U1.75 (PB14), U4.9 (QH')
SPI2_MOSI: U1.76 (PB15), U4.14 (SER)
SPI2_NSS: U1.73 (PB12), U4.12 (RCLK)
SPI2_SCK: U1.74 (PB13), U4.11 (SRCLK)
SPI3_MISO: SD2.7 (DAT0), U1.134 (PB4(NJTRST))
SPI3_MOSI: SD2.2 (CMD), U1.135 (PB5)
SPI3_NSS: SD2.1 (CD/DAT3), U1.110 (PA15(JTDI))
SPI3_SCK: SD2.5 (CLK), U1.133 (PB3(JTDO)
SPI5_MISO: U1.20 (PF8), U2.28 (GPIOL_09_CDI1)
SPI5_MOSI: U1.21 (PF9), U2.29 (GPIOL_08_CDI0)
SPI5_NSS: U1.18 (PF6), U2.6 (GPIOL_46)
SPI5_SCK: U1.19 (PF7), U2.30 (GPIOL_01_CCK)
SSPARE1: J1.AE1
SSPARE2: J1.AF1
SSPARE3: J1.AH1
SSPARE8: J1.BH1
SWCLK: J3.4, U1.109 (PA14(JTCK)
SWDIO: J3.2, U1.105 (PA13(JTMS)
TDI: J3.8
TDO: J3.6
TEST_N: R25.2, U2.74 (GPIOR_158_TEST_N)
TRACECK: J3.12, U1.1 (PE2)
TRACED0: J3.14, U1.128 (PG13)
TRACED1: J3.16, U1.129 (PG14)
TRACED2: J3.18, U1.116 (PD2)
TRACED3: J3.20, U1.113 (PC12)
TXD: TP44.1, U1.101 (PA9)
USB_D+: U1.104 (PA12), U9.4
USB_D-: U1.103 (PA11), U9.6
VCCA_BR: C2.1, C56.1, FB4.2, U2.73 (VCCA_BR)
VCCA_TL: C29.1, C57.1, FB2.2, U2.2 (VCCA_TL)
VCCA_TR: C33.1, C58.1, FB3.2, U2.107 (VCCA_TR)
VDDA_0: C2.1, C39.1, FB1.2, U1.33 (VDDA)
WRITE_PROTECT_1: R36.1, SD1.11 (WRITE_PROTECT), U1.139 (PB8)
WRITE_PROTECT_2: R38.1, SD2.11 (WRITE_PROTECT), U1.132 (PG15)
nRESET: C5.1, J3.10, R4.1, RESET0.1, U1.25 (NRST)

Notes on the sheet:
Solder jumpers for SPI vs. SD interface: SPI SD/MMC ----- ------ JP1 1-2 2-3 JP2 1-2 2-3
CSI
CBSEL[0]
-12
+12
SS_N
bypasses for U2 core
CBUS[1]
CBUS[2]
CBSEL[1]
bypasses for U2 I/O
+5 bypass
bypasses for U2 PLLs
TEST_N
bypasses for U1
CBUS[0]
scope ground points
