jrengdahl/MSCP/MSCP.ioc

Mcu.UserName=STM32H723ZGTx
PA0.GPIO_Label=CRESET_N
PA0.Signal=GPIO_Output
PA11.Signal=USB_OTG_HS_DM
PA12.Signal=USB_OTG_HS_DP
PA13(JTMS/SWDIO).Signal=DEBUG_JTMS-SWDIO
PA14(JTCK/SWCLK).Signal=DEBUG_JTCK-SWCLK
PA15(JTDI).GPIO_Label=SPI3_NSS
PA15(JTDI).Signal=GPIO_Output
PA3.GPIO_Label=PA3
PA3.Signal=GPIO_Input
PA4.GPIO_Label=PA4
PA4.Signal=GPIO_Input
PA6.Signal=OCTOSPIM_P1_IO3
PA7.Signal=OCTOSPIM_P1_IO2
PB0.Signal=OCTOSPIM_P1_IO1
PB1.Signal=OCTOSPIM_P1_IO0
PB10.Signal=OCTOSPIM_P1_NCS
PB12.Signal=SPI2_NSS
PB13.Signal=SPI2_SCK
PB14.Signal=SPI2_MISO
PB15.Signal=SPI2_MOSI
PB2.Signal=OCTOSPIM_P1_CLK
PB3(JTDO/TRACESWO).Signal=SPI3_SCK
PB4(NJTRST).Signal=SPI3_MISO
PB5.Signal=SPI3_MOSI
PB7.Signal=FMC_NL
PC10.GPIO_Label=LED1
PC10.Signal=GPIO_Output
PC11.GPIO_Label=LED0
PC11.Signal=GPIO_Output
PC12.Signal=DEBUG_TRACED3
PC13.GPIO_Label=CDONE
PC13.Signal=GPIO_Input
PC7.Signal=FMC_NE1
PC9.GPIO_Label=LED2
PC9.Signal=GPIO_Output
PD0.Signal=FMC_D2_DA2
PD1.Signal=FMC_D3_DA3
PD10.Signal=FMC_D15_DA15
PD11.Signal=FMC_A16_CLE
PD12.Signal=FMC_A17_ALE
PD13.Signal=FMC_A18
PD14.Signal=FMC_D0_DA0
PD15.Signal=FMC_D1_DA1
PD2.Signal=DEBUG_TRACED2
PD3.GPIO_Label=FPGA_IRQ
PD3.Signal=GPXTI3
PD4.Signal=FMC_NOE
PD5.Signal=FMC_NWE
PD7.Signal=SPI1_MOSI
PD8.Signal=FMC_D13_DA13
PD9.Signal=FMC_D14_DA14
PE0.Signal=FMC_NBL0
PE1.Signal=FMC_NBL1
PE10.Signal=FMC_D7_DA7
PE11.Signal=FMC_D8_DA8
PE12.Signal=FMC_D9_DA9
PE13.Signal=FMC_D10_DA10
PE14.Signal=FMC_D11_DA11
PE15.Signal=FMC_D12_DA12
PE2.Signal=DEBUG_TRACECLK
PE3.Signal=FMC_A19
PE4.Signal=FMC_A20
PE5.Signal=FMC_A21
PE6.Signal=FMC_A22
PE7.Signal=FMC_D4_DA4
PE8.Signal=FMC_D5_DA5
PE9.Signal=FMC_D6_DA6
PF11.GPIO_Label=NSTATUS
PF11.Signal=GPIO_Input
PF7.GPIO_Label=SPI5_SCK
PF7.Signal=SPI5_SCK
PF8.GPIO_Label=SPI5_MISO
PF8.Signal=SPI5_MISO
PF9.GPIO_Label=SPI5_MOSI
PF9.Signal=SPI5_MOSI
PG10.GPIO_Label=SPI1_NSS
PG10.Signal=GPIO_Output
PG11.Signal=SPI1_SCK
PG13.Signal=DEBUG_TRACED0
PG14.Signal=DEBUG_TRACED1
PG9.Signal=SPI1_MISO
PH0-OSC_IN.Signal=RCC_OSC_IN
