jrengdahl/MSCP/Core/Inc/main.h

#define CDONE_Pin GPIO_PIN_13
#define CDONE_GPIO_Port GPIOC
#define SPI5_SCK_Pin GPIO_PIN_7
#define SPI5_SCK_GPIO_Port GPIOF
#define SPI5_MISO_Pin GPIO_PIN_8
#define SPI5_MISO_GPIO_Port GPIOF
#define SPI5_MOSI_Pin GPIO_PIN_9
#define SPI5_MOSI_GPIO_Port GPIOF
#define CRESET_N_Pin GPIO_PIN_0
#define CRESET_N_GPIO_Port GPIOA
#define PA3_Pin GPIO_PIN_3
#define PA3_GPIO_Port GPIOA
#define PA4_Pin GPIO_PIN_4
#define PA4_GPIO_Port GPIOA
#define NSTATUS_Pin GPIO_PIN_11
#define NSTATUS_GPIO_Port GPIOF
#define LED2_Pin GPIO_PIN_9
#define LED2_GPIO_Port GPIOC
#define SPI3_NSS_Pin GPIO_PIN_15
#define SPI3_NSS_GPIO_Port GPIOA
#define LED1_Pin GPIO_PIN_10
#define LED1_GPIO_Port GPIOC
#define LED0_Pin GPIO_PIN_11
#define LED0_GPIO_Port GPIOC
#define FPGA_IRQ_Pin GPIO_PIN_3
#define FPGA_IRQ_GPIO_Port GPIOD
#define FPGA_IRQ_EXTI_IRQn EXTI3_IRQn
#define SPI1_NSS_Pin GPIO_PIN_10
#define SPI1_NSS_GPIO_Port GPIOG
