jrengdahl/MSCP/Core/Src/commas.cpp

#include <stdint.h>
#include <stdio.h>

// print a large number with commas
void commas(uint32_t x)
    {
    if(x>=1000000000)
        {
        printf("%lu,%03lu,%03lu,%03lu", x/1000000000, x/1000000%1000, x/1000%1000, x%1000);
        } // those are "L"s after the threes, not ones
    else if(x>=1000000)
        {
        printf("%lu,%03lu,%03lu", x/1000000, x/1000%1000, x%1000);
        }
    else if(x>=1000)
        {
        printf("%lu,%03lu", x/1000%1000, x%1000);
        }
    else printf("%lu", x);
    }
