jrengdahl/MSCP/Core/Src/bear.cpp

// Print the Bear Metal logo

// Copyright (c) 2023 Jonathan Engdahl
// BSD license -- see the accompanying LICENSE file

// The bear image is in the public domain. It is from The Hiawatha Primer, by Florence Holbrook, 1898, page 21.
// The book can be found here: https://www.google.com/books/edition/The_Hiawatha_Primer/2NEAAAAAYAAJ 
// or here: https://archive.org/search?query=hiawatha+primer
// A downloadable .png version of the image can be found here: https://www.wpclipart.com/animals/B/bears/black_bear/black_bear_silhouette.png.html
// I converted it to text many years ago using an automated ASCII art converter, I can't remember which one.

// There are multiple web sites which can produce the lettering. The font is JS Stick Letters. Here is one such site:
// https://patorjk.com/software/taag/#p=display&f=JS%20Stick%20Letters&t=Bear%20Metal


#include <stdio.h>

void bear(void)
        {
        printf("\n\n");
        printf("                ;iIVYti=;;;;:... :;;\n");
        printf("            :iRBMMMMMMMMMMMMMMMMMMMMMBI=.\n");
        printf("          ;RMMMMMMMMMMMMMMMMMMMMMMMMMMMMMRt:i.   .\n");
        printf("        .VMMMMMMMMMMMMMMMMMMMMMMMMMMMMMMMMMMMB;IBB.\n");
        printf("       .BMMMMMMMMMMMMMMMMMMMMMMMMMMMMMMMMMMMMMMMMB\n");
        printf("       RMMMMMMMMMMMMMMMMMMMMMMMMMMMMMMMMMMMMMMMMMR\n");
        printf("       RMMMMMMMMMMMMMMMMMMMMMMMMMMMMMMMMMMMMMMMMMMR\n");
        printf("       BMMMMMMMMMMMMMMMMMMMMMMMMMMMMMMMMMMMMMMMMMMM=\n");
        printf("      iMMMMMMMMMMMMMMMMMMMMMMMMMMMMMMMMMMBMMMMMMMMMBi\n");
        printf("     iBMMMMMMMMMMMMMBBVBBRMMMMMMRBBMMMMMB.:RRi+=tBMBY.\n");
        printf("    RMMMMMMMMMMMMMMI     iMMMMB;  .RMMMMMi        ~\n");
        printf("  ;BMMMMMBX=BMMMMMt      RMMMB:     RMMMMB\n");
        printf(" BMMMBBI;   BMMMMt       BMMMt       ;BMMMV\n");
        printf(" BMMB       BMMMR        BMMB         :BMMM;\n");
        printf(" .BMMRt;    BMMMBIt=.    RMMB;;        .VMMBXYi.\n");
        printf("     __   ___       __            ___ ___\n");
        printf("    |__) |__   /\\  |__)     |\\/| |__   |   /\\  |\n");
        printf("    |__) |___ /~~\\ |  \\     |  | |___  |  /~~\\ |___\n");
        printf("\n");
        }
