jrengdahl/MSCP/(commit log)

2024-05-20 Got a bear!
    The bug was that the loop testing vcp_init_complpete was optimized to an
    infinite loop. The fix was inserting a COMPILER_BARRIER in the loop.
    [MSCP.ioc, cmsis.h, main.c]
2024-05-20 Get TIM2 working.
    Calibrate works.
2024-05-20 Got variable clock speed working correctly.
    Calibrate and TIM2 work correctly.
    Default speed is 100 MHz.
    Max spec speed is 550 MHz.
    Overclocking seems to work up to 750 MHz.
    Fixed USB VCP interface so that CubeMX no longer overwrites my changes
    every time it updates the autogenerated code.
    [MSCP.ioc, interp.cpp, main.c, serial.cpp]
2024-05-22 Working on getting the temperature sensor to give reasonable values
2024-05-27 add background temperature monitoring
    increase number of OMP threads, since the H723 has more RAM
2024-05-27 Add KiCAD board project; update README
    [QBusH723Z.kicad_sch, bom.csv, positions.csv]
2024-05-27 temp_verbose is now the min interval between temperature reports
2024-05-28 add SPI2 test comand
    tx works, readback does not work yet
    [MSCP.ioc, interp.cpp, main.c]
2024-06-07 debugging QSPI-to-Winbond SPI-NOR, not working yet
    [MSCP.ioc, interp.cpp, main.c]
2024-06-10 Add and debug transfer of FATFS image from PC to SPI-NOR via XMODEM.
2024-06-26 QBus writes working, more testing needed.
    Using edge-triggered FF for registers fixed the writes.
    Need to improve this.
    Debugger LA not working right.
    [qbus.sv]
2024-07-03 Change H723 read of IT to a read and clear.
    There is a very small window where an interrupt could be lost. This
    needs to be fixed later.
    [qbus.sv]
2024-07-05 Added SV code for DMA and bus master.
    Some reorg and cleanup of qbus.sv.
    Added constraint (SDC) file.
    Compiles without error, but not tested yet.
    [qbus.sv]
2024-07-09 Add Qbus.cpp with Qwrite function; byte ops, read, and DMA to come later.
    Update MX Cube version.
    Add false paths to qbus.sdc to reduce warnings.
2024-07-15 debugging Qbus DMA reads and writes; writes seem to work, reads don't
2024-07-16 Qbus reads and writes work now.
    Added code to read/write up to 8 words per DMA.
    Added code to repeat a DMA operation for timing analysis.
2024-07-16 Optimize Qbus DMA read and write.
    Tested OK with CPU clock at 100, 250, and 500 MHz.
2024-07-17 Added SPI SD card driver.
    Following instructions at
    https://deepbluembedded.com/stm32-sd-card-spi-fatfs-tutorial-examples
    It compiles, but not tested yet. It still needs a lot of work.
2024-07-19 Tested FATFS_SD.c SD card driver via SPI port. Got it working.
    The code (and tutorial) came from:
    A couple mods to the SD-SPI driver were required.
    Updated my test code to try out the SD card.
    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
2024-07-19 Added mnt, fmt, ls, and cat commands to interp.cpp.
    These are not 100% right, I think I need a separate FATFS object for
    each drive. So right now, only the last drive to have been mounted can
    be accesed. Will be fixed later.
    That's what incremental refinement is all about.
    The fmt command has not been tested yet. It's mostly for the QSPI
    anyhow.
    [interp.cpp]
2024-07-19 Fixed mount problem by adding multiple FATFS structs
    [interp.cpp]
2024-07-20 removed lun from Disk_drvTypeDef
    It didn't seem to be used anywhere, and it was messing up my
    user_diskio.c.
    user_diskio.c expects the drive number, but diskio.c was passing the
    lun, which was always zero, no matter which drive was in the path.
    Compiles but not teted yet.
    [main.c]
2024-08-25 wrote a bunch of new code for UQSSP and MSCP, which assuredly does not work yet
    [BootRom_tmpl.vhd, MSCP.cpp, MSCP.h, Qbus.cpp, Qbus.hpp, Xmodem.cpp]
2024-09-06 Implement write command;
    add MSCP error reporting;
    other minor tweaks.
    Changes not tested yet.
    [MSCP.cpp, MSCP.hpp, uqssp.hpp]
2025-01-26 cleanup after CubeMX update
    It compiles with no errors or warnings, but has not been tested in a
    while.
    [MSCP.ioc, Xmodem.cpp, main.c]
2025-02-13 Implement FPGA programming via SPI port.
    Got it working.
2025-02-20 Add code to program the FPGA from a file in the QSPI at powerup.
    Improve the stability of the XModem download to aQSPI.
    Some refactoring.
    Added a test register to the FPGA.
    Bit 0 asserts FPGA_IRQ for testing purposes.
    [ClkCommand.cpp, ProgramFPGA.cpp, QspiCommand.cpp, Xmodem.cpp, interp.cpp, qbus.sv]
2025-02-21 Added FPGA IRQ test code.
    Added a FPGA monitor thread.
    Init FPGA IRQ after FPGA is programmed at powerup.
    Add code to background to start the new thread, and poll the FPGA_IRQ
    flag set by the IRQ.
2025-02-22 Experimented with using OpenMP "sections" to create the background threads.
    It didn't work, so I reverted that change.
    There were some minor byproducts of the experimentation.
    [background.cpp, context.hpp, libgomp.cpp, libgomp.hpp]
2025-02-22 Added a line to clear the FPGA_IRQ at powerup.
    This gets rid of a spurious interrupt right after the FPGA is
    programmed.
2026-09-28 snapshot after a long time not working on this project, and before messing with codex
    [background.cpp, libgomp.cpp, libgomp.hpp]
2026-10-08 Fix diff command.
    Fix QSPI block size.
    Add error checking.
    [CpCommand.cpp, DiffCommand.cpp, main.c, uqssp.cpp]
2026-10-09 Added an AI-generated NOR flash write routine that can write 512-byte blocks.
    It correctly handles 4096-byte erase sectors.
    [NorFatFsShim.cpp, NorFatFsShim.h]
